dwitt/pi-dgc/PiDGC PCB/PiDGC.brd

## EAGLE design PiDGC PCB/PiDGC.brd (2021-03-28)

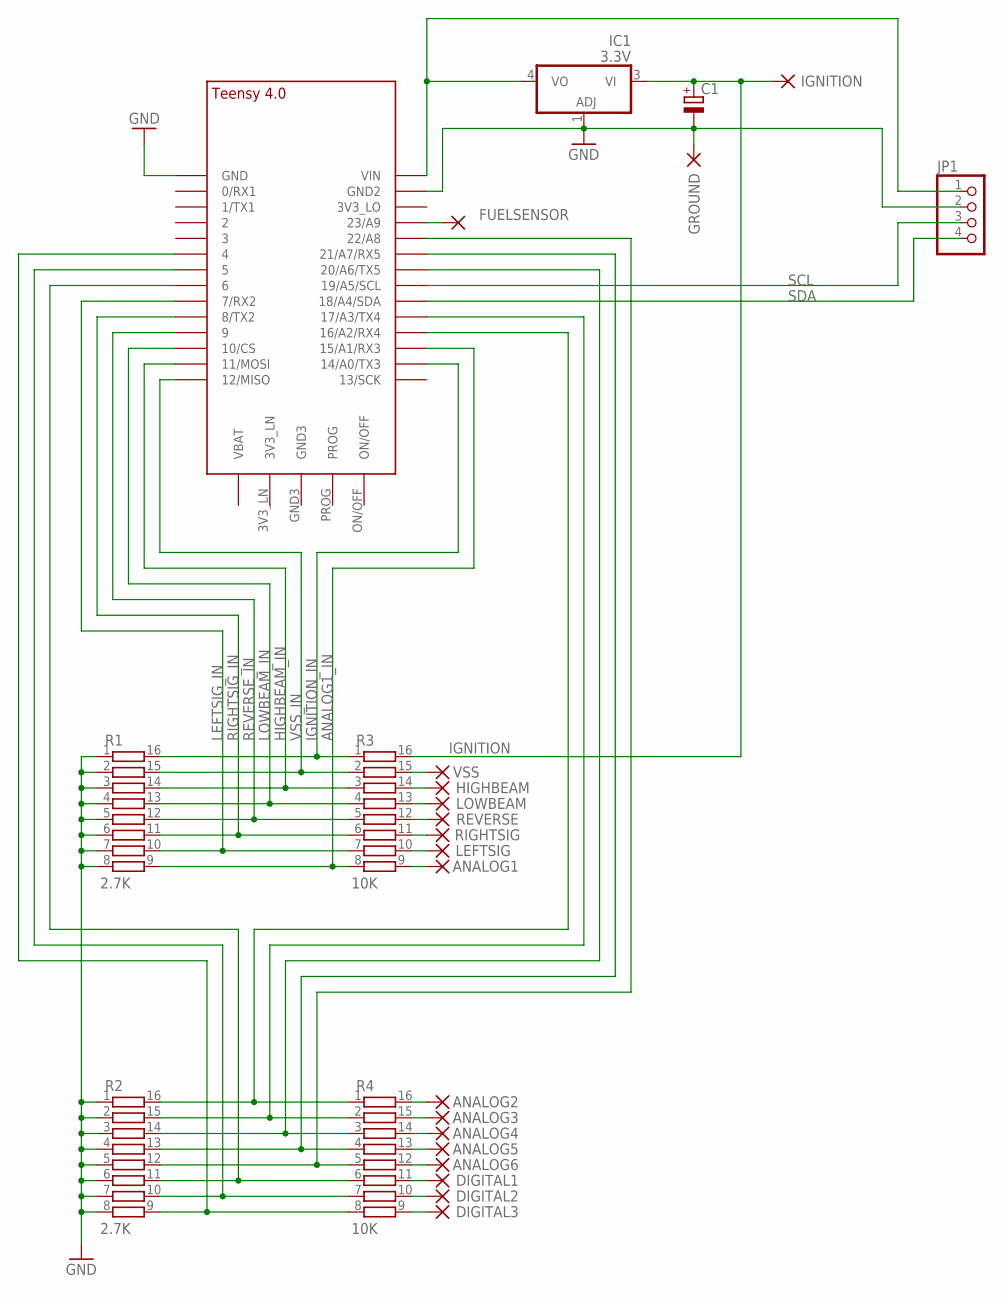
[picture p1: schematic PiDGC.sch]

Parts:
ANALOG1, ANALOG2, ANALOG3, ANALOG4, ANALOG5, ANALOG6: WIREPAD3,81/1,4; 3,81/1,4
C1: CPOL-EUE7.5-16; E7,5-16
DIGITAL1, DIGITAL2, DIGITAL3: WIREPAD3,81/1,4; 3,81/1,4
FUELSENSOR: WIREPAD3,81/1,4; 3,81/1,4
GROUND: WIREPAD3,81/1,4; 3,81/1,4
HIGHBEAM: WIREPAD3,81/1,4; 3,81/1,4
IC1: 3.3V; SOT223
IGNITION: WIREPAD3,81/1,4; 3,81/1,4
JP1: PINHD-1X4; 1X04
LEFTSIG: WIREPAD3,81/1,4; 3,81/1,4
LOWBEAM: WIREPAD3,81/1,4; 3,81/1,4
R1, R2: 2.7K; SO16
R3, R4: 10K; SO16
REVERSE: WIREPAD3,81/1,4; 3,81/1,4
RIGHTSIG: WIREPAD3,81/1,4; 3,81/1,4
U$1: TEENSY_4.0
VSS: WIREPAD3,81/1,4; 3,81/1,4

Connections:
ANALOG1_IN: R1.9, R3.8, U$1.15/A1 (15/A1/RX3)
GND: C1.-, GROUND.1, IC1.1 (ADJ), JP1.2, R1.1, R1.2, R1.3, R1.4, R1.5, R1.6, R1.7, R1.8, R2.1, R2.2, R2.3, R2.4, R2.5, R2.6, R2.7, R2.8, U$1.GND, U$1.GND2
HIGHBEAM_IN: R1.14, R3.3, U$1.11/MOSI
IGNITION: C1.+, IC1.3 (VI), IGNITION.1, R3.16
IGNITION_IN: R1.16, R3.1, U$1.14/A0 (14/A0/TX3)
LEFTSIG_IN: R1.10, R3.7, U$1.7 (7/RX2)
LOWBEAM_IN: R1.13, R3.4, U$1.10/CS
unnamed: IC1.4 (VO), JP1.1, U$1.VIN
unnamed: R2.16, R4.1, U$1.16/A2 (16/A2/RX4)
unnamed: R2.15, R4.2, U$1.17/A3 (17/A3/TX4)
unnamed: R2.14, R4.3, U$1.20/A6 (20/A6/TX5)
unnamed: R2.13, R4.4, U$1.21/A7 (21/A7/RX5)
unnamed: R2.12, R4.5, U$1.22/A8
unnamed: R2.11, R4.6, U$1.6
unnamed: R2.10, R4.7, U$1.5
unnamed: R2.9, R4.8, U$1.4/CANRX (4)
unnamed: R3.15, VSS.1
unnamed: HIGHBEAM.1, R3.14
unnamed: LOWBEAM.1, R3.13
unnamed: R3.12, REVERSE.1
unnamed: R3.11, RIGHTSIG.1
unnamed: LEFTSIG.1, R3.10
unnamed: ANALOG1.1, R3.9
unnamed: ANALOG2.1, R4.16
unnamed: ANALOG3.1, R4.15
unnamed: ANALOG4.1, R4.14
unnamed: ANALOG5.1, R4.13
unnamed: ANALOG6.1, R4.12
unnamed: DIGITAL1.1, R4.11
unnamed: DIGITAL2.1, R4.10
unnamed: DIGITAL3.1, R4.9
unnamed: FUELSENSOR.1, U$1.23/A9
REVERSE_IN: R1.12, R3.5, U$1.9/CS (9)
RIGHTSIG_IN: R1.11, R3.6, U$1.8 (8/TX2)
SCL: JP1.3, U$1.19/A5/SCL
SDA: JP1.4, U$1.18/A4/SDA
VSS_IN: R1.15, R3.2, U$1.12/MISO

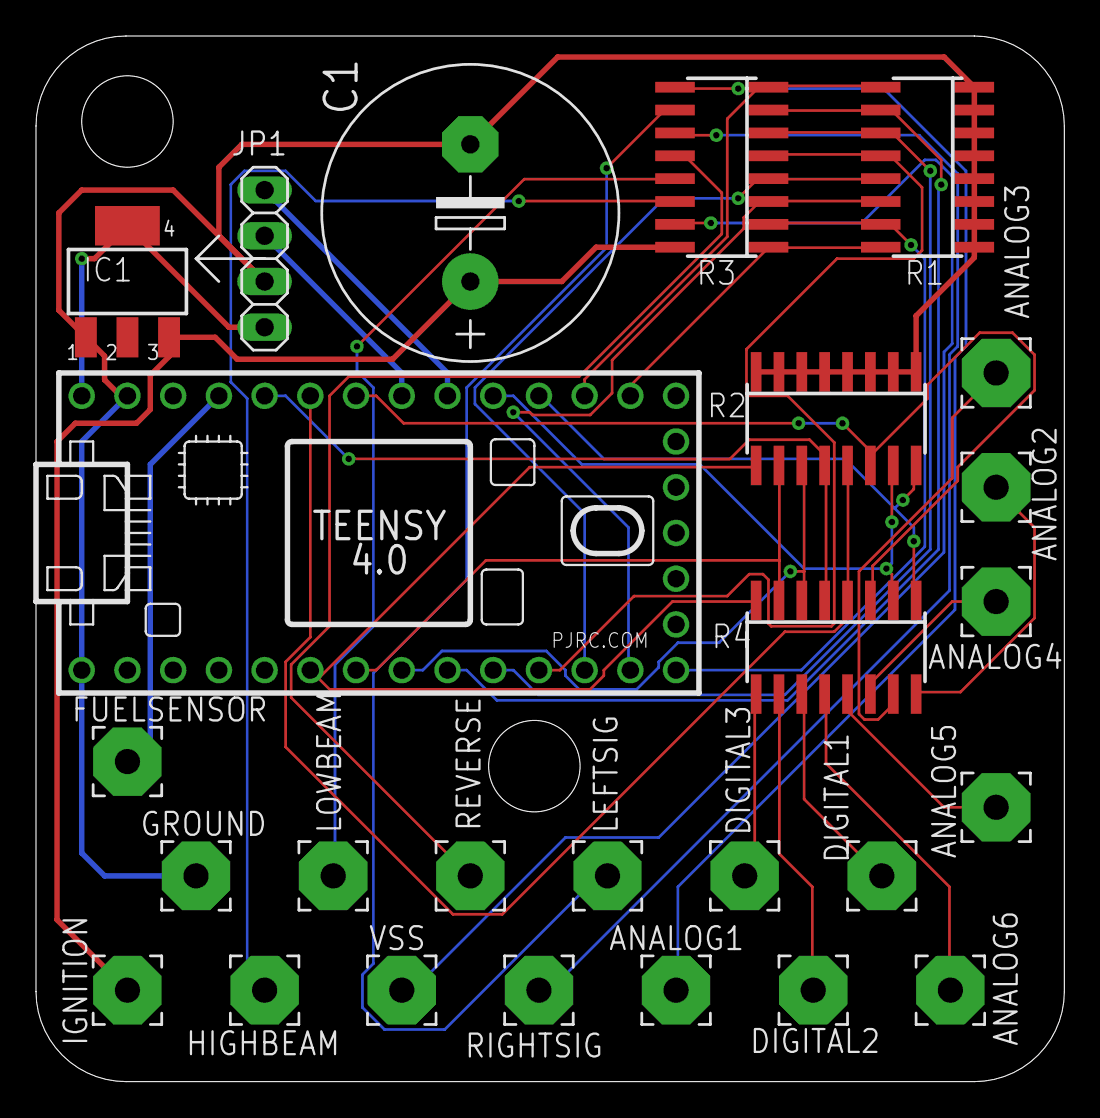
[picture p2: board PiDGC.brd from above]

Board: 2 copper layers, 57.1 x 58.1 mm, 26 parts (0 on the bottom side), 37 nets.
