dwitt/pi-dgc/(commit log)

2021-02-21 Backup camera code
2021-02-22 Revert "Convert to 1920x720"
    This reverts commit 63595c39b0dd3ec087ce2cecf5d90b94b98e0e2a.
    [simulator.ino]
2021-02-23 Faster spring startup
2021-03-17 Add schematic/pcb/etc.
    [PiDGC.brd, PiDGC.sch]
2021-03-28 More work
    [PiDGC.brd, PiDGC.sch]
